chudsaviet/avr-batt-timer/hardware/avr-batt-timer/avr-batt-timer.kicad_pcb

## KiCad design hardware/avr-batt-timer/avr-batt-timer.kicad_pcb (2025-01-26)

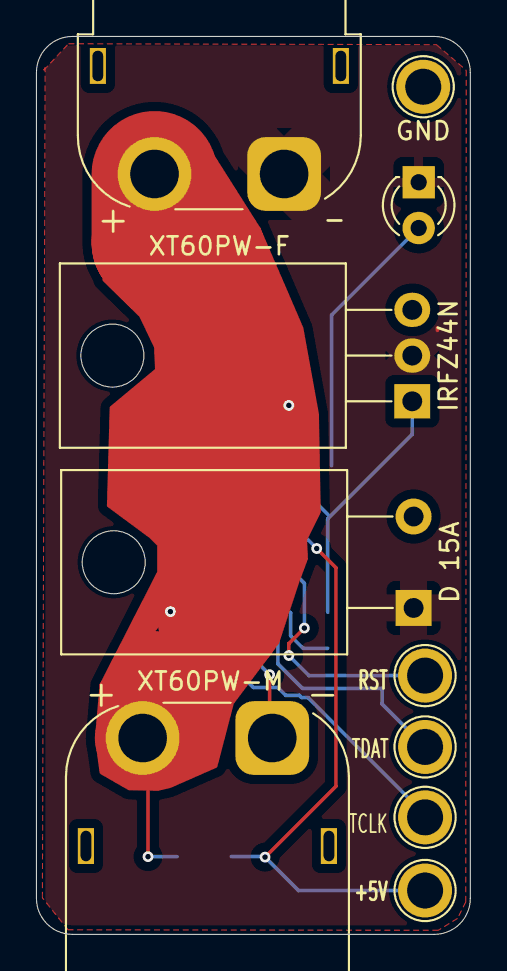
[picture p1: board avr-batt-timer.kicad_pcb from above]

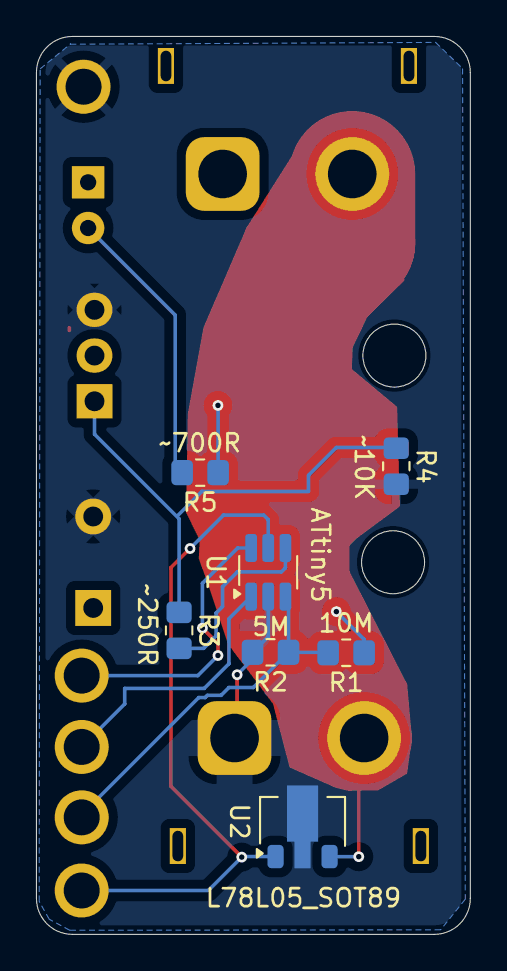
[picture p2: board avr-batt-timer.kicad_pcb from below]

Board: 2 copper layers, 24.1 x 49.9 mm, 17 parts (7 on the bottom side), 10 nets.

Parts:
D1: LED; LED_D3.0mm
D2: D 15A; TO-220-2_Horizontal_TabDown
J1: XT60PW-M; AMASS_XT60PW-M_1x02_P7.20mm_Horizontal
J2: XT60PW-F; AMASS_XT60PW-F_1x02_P7.20mm_Horizontal
MOSFET1: IRFZ44N; TO-220-3_Horizontal_TabDown
R1: 10M; R_0805_2012Metric_Pad1.20x1.40mm_HandSolder
R2: 5M; R_0805_2012Metric_Pad1.20x1.40mm_HandSolder
R3: ~250R; R_0805_2012Metric_Pad1.20x1.40mm_HandSolder
R4: ~10K; R_0805_2012Metric_Pad1.20x1.40mm_HandSolder
R5: ~700R; R_0805_2012Metric_Pad1.20x1.40mm_HandSolder
TP1: +5V; TestPoint_Plated_Hole_D2.0mm
TP2: RST; TestPoint_Plated_Hole_D2.0mm
TP3: TDAT; TestPoint_Plated_Hole_D2.0mm
TP4: TCLK; TestPoint_Plated_Hole_D2.0mm
TP5: GND; TestPoint_Plated_Hole_D2.0mm
U1: ATtiny5; SOT-23-6_Handsoldering
U2: L78L05_SOT89; SOT-89-3

Connections:
+5V: TP1.1, U1.5 (VCC), U2.1 (OUT)
GND: D2.2 (A), J1.1, MOSFET1.3 (S), R2.2, R4.2, TP5.1, U1.2 (GND), U2.2 (GND)
LOAD: D1.1 (K), D2.1 (K), J2.1, MOSFET1.2 (D)
unnamed: D1.2 (A), R5.2
unnamed: MOSFET1.1 (G), R3.1, R4.1
unnamed: R3.2, U1.4 (PB2)
RESET: TP2.1, U1.6 (~RESET/PB3)
TPICLK: R1.2, R2.1, TP4.1, U1.3 (PB1)
TPIDATA: TP3.1, U1.1 (PB0)
VDD: J1.2, J2.2, R1.1, R5.1, U2.3 (IN)
