chudsaviet/avr-batt-timer/src/main.c

#define F_CPU 1000000UL

#include <avr/interrupt.h>
#include <avr/io.h>
#include <avr/sleep.h>
#include <avr/wdt.h>

// Voltages units are determined based on the fact MCU supply is 5V and ADC
// measures in 0-255 units where 255 is the supply voltage. We also have 1/3
// voltage divider in the circuit.
#define VOLTAGE_UNITS_ALTERNATOR_ON 225  // ~ 13.2V
#define VOLTAGE_UNITS_BATTERY_LOW 211    // ~ 12.4V

// If an iteration happens every 4 seconds, 225 iterations is approximately 15
// minutes.
#define LOAD_OFF_TIMEOUT_ITERATIONS_COUNT 225

#define PORTB_ADC_PIN PORTB1
#define PORTB_LOAD_PIN PORTB2

typedef enum MachineState {
  MACHINE_STATE_ALTERNATOR_ON,
  MACHINE_STATE_WAITING,
  MACHINE_STATE_LOAD_OFF
} MachineState;

typedef enum VoltageState {
  VOLTAGE_STATE_ALTERNATOR_ON,
  VOLTAGE_STATE_ALTERNATOR_OFF,
  VOLTAGE_STATE_BATTERY_LOW
} VoltageState;

void setup() {
  // Disable all interrupts.
  cli();

  // Set CPU clock source to internal 8 MHz oscillator.
  CLKMSR = 0;
  // Divide main clock by 8, which will set clock to 1 MHz.
  CLKPSR = 0b0011;

  // Setup PORTB - all input except PORTB_LOAD_PIN.
  DDRB = 1 << PORTB_LOAD_PIN;
  // Disable internal pull-up resistor on PORTB1 and PORTB_LOAD_PIN.
  PUEB &= ~(1 << PORTB_ADC_PIN) & ~(1 << PORTB_LOAD_PIN);

  // Set ADC muxer to connect to pin 1.
  ADMUX = ADC1;
  // Disable digital input on all pins - not needed, we just have an analog input on pin 1.
  DIDR0 = 0xFF;

  // Setup watchdog.
  // Set to 2s timeout, enable watchdog interrupt, disable watchdog reset.
  WDTCSR = (0 << WDP3) | (1 << WDP2) | (1 << WDP1) | (1 << WDP0) | (1 << WDIE) |
           (0 << WDE);

  // Enable interrupts back.
  sei();
}

uint8_t read_voltage_units() {
  // Power on and enable the ADC. Enable the ADC interrupt.
  PRR = ~(1 << PRADC);
  ADCSRA = (1 << ADEN) | (1 << ADIE);

  // Go to ADC Noise Reduction sleep mode.
  // ADC conversion will start.
  SMCR = SLEEP_MODE_ADC | (1 << SE);
  sleep_cpu();

  // Woke up by the ADC interrupt when converstion has been completed.
  uint8_t adc_measurement = ADCL;

  // Turn off and power down the ADC.
  ADCSRA = 0;
  PRR = 0xFF;

  return adc_measurement;
}

VoltageState get_voltage_state() {
  uint8_t voltage_units = read_voltage_units();
  if (voltage_units <= VOLTAGE_UNITS_BATTERY_LOW) {
    return VOLTAGE_STATE_BATTERY_LOW;
  } else if (voltage_units < VOLTAGE_UNITS_ALTERNATOR_ON) {
    return VOLTAGE_STATE_ALTERNATOR_OFF;
  } else {
    return VOLTAGE_STATE_ALTERNATOR_ON;
  }
}

void load_off() { PORTB &= ~(1 << PORTB_LOAD_PIN); }

void load_on() { PORTB |= 1 << PORTB_LOAD_PIN; }

int main() {
  setup();

  MachineState machine_state = MACHINE_STATE_ALTERNATOR_ON;
  uint8_t iteration_counter = 0;
  while (true) {
    VoltageState voltage_state = get_voltage_state();

    // Disable all interrupts when running state machine logic.
    cli();
    switch (voltage_state) {
      case VOLTAGE_STATE_BATTERY_LOW:
        load_off();
        machine_state = MACHINE_STATE_LOAD_OFF;
        break;
      case VOLTAGE_STATE_ALTERNATOR_OFF:
        if (machine_state != MACHINE_STATE_WAITING) {
          iteration_counter = 0;
        } else {
          if (iteration_counter >= LOAD_OFF_TIMEOUT_ITERATIONS_COUNT) {
            load_off();
          } else {
            iteration_counter++;
          }
        }
        machine_state = MACHINE_STATE_WAITING;
        break;
      case VOLTAGE_STATE_ALTERNATOR_ON:
        load_on();
        machine_state = MACHINE_STATE_ALTERNATOR_ON;
        break;
      default:
        break;
    }
    // Enable interrupts back.
    sei();

    // Power down and wait to be woke up by a watchdog interrupt.
    SMCR = SLEEP_MODE_PWR_DOWN | (1 << SE);
    sleep_cpu();
  }
  return 0;
}
