chudsaviet/avr-batt-timer/(commit log)

2024-12-18 Added KiCad project.
    [avr-batt-timer.kicad_pcb, avr-batt-timer.kicad_sch]
2024-12-18 Initial schematic.
    [avr-batt-timer.kicad_sch]
2024-12-21 Added most components.
    [avr-batt-timer.kicad_sch]
2024-12-22 Added components. Initial PCB design.
    [avr-batt-timer.kicad_pcb, avr-batt-timer.kicad_sch]
2025-01-10 Fixed TPICLK pin connection. Replaced programming pins with holes.
    [avr-batt-timer.kicad_pcb, avr-batt-timer.kicad_sch]
2025-01-26 Last version with attiny5.
    [avr-batt-timer.kicad_pcb]
